102637111/bzliuxing-wing-backpack-shaft/images/photo_front.jpg

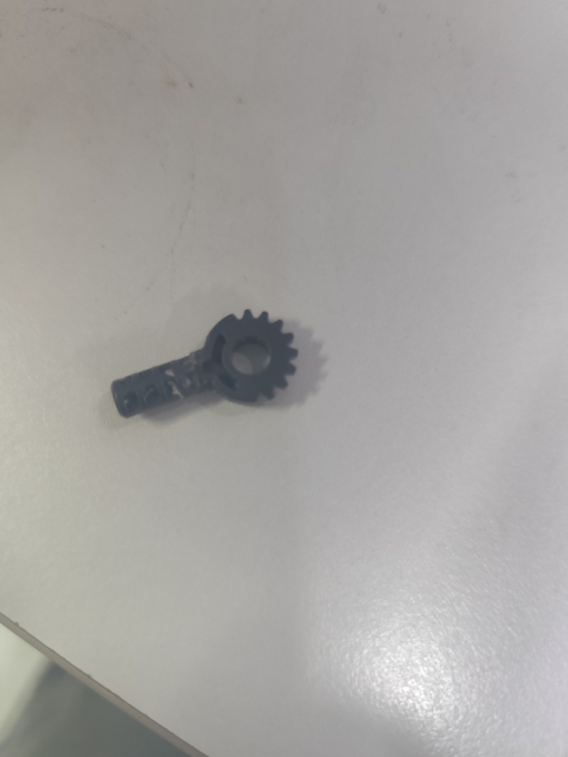
images/photo_front.jpg
