102637111/bzliuxing-wing-backpack-shaft/stl/wing_backpack_shaft_1-12.stl

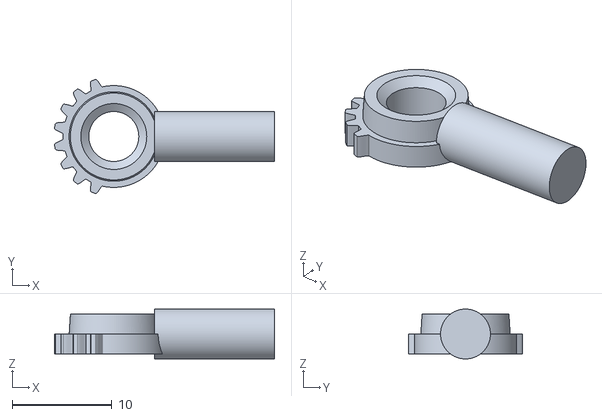
[picture p8: CAD file, 2026-10-25]
stl/wing_backpack_shaft_1-12.stl
22.0 x 11.4 x 5.00
