102637111/bzliuxing-wing-backpack-shaft/(list of files, cad)

Other CAD files:
model/connector.blend
