102637111/bzliuxing-wing-backpack-shaft/(commit log)

2026-10-25 Add 1/12 wing-backpack connector shaft (reverse-engineered, print-verified)
    Parametric Blender model of the radial shaft that connects the wings to
    the backpack on the SOULMOULD 白昼流星 1/12 kit. Dimensions taken from
    photos of the original part (gear tip Ø12 incl. teeth, 8-tooth 160°
    sector, 20° pitch, Ø9 upper ring, Ø5 bore, Ø5×11 shaft).
    The included STL is the round-shaft variant, verified by an actual print.
    The flattened-shaft variant was tested too and came out loose, so it is
    not the default.
    [connector.blend, wing_backpack_shaft_1-12.stl]
2026-10-25 Add installed-on-kit photo and model-site listing copy
    - images/installed_on_kit.jpg: user photo of the part installed on the
    assembled kit; shown in the README under "On the assembled kit"
    - docs/publish-printables.md: ready-to-paste title, summary, tags and
    description (zh/en) for Printables / MakerWorld
    - README: link to the latest release and to the bundled STL
    - dist zip refreshed with the new photo
